bitraf/bitraf-hydroponics/board_1.1/bitraf_hydroponics-checks.md

Found probems: errors: 3, warnings: 16, notes: 1

General notes:
  highest-component: Highest component C2 is 1.45 mm

Ref: L1, MPN: NRS8040T150MJGJ
  mismatched-footprint: From schema: 'Inductors_SMD:L_Taiyo-Yuden_NR-80xx', from part database: 'Nonstandard'
Ref: P1, MPN: 1702473
  mismatched-footprint: No info about footprint from Digi-Key for 1702473
Ref: P10, MPN: 826926-4
  mismatched-footprint: No info about footprint from Digi-Key for 826926-4
Ref: P11, MPN: 1702473
  mismatched-footprint: No info about footprint from Digi-Key for 1702473
Ref: P12, MPN: 1702473
  mismatched-footprint: No info about footprint from Digi-Key for 1702473
Ref: P13, MPN: 826926-3
  mismatched-footprint: No info about footprint from Digi-Key for 826926-3
Ref: P14
  missing-part-number
Ref: P15, MPN: 826926-6
  mismatched-footprint: No info about footprint from Digi-Key for 826926-6
Ref: P16, MPN: PPPC031LFBN-RC
  mismatched-footprint: No info about footprint from Digi-Key for PPPC031LFBN-RC
Ref: P2, MPN: 1702473
  mismatched-footprint: No info about footprint from Digi-Key for 1702473
Ref: P3, MPN: 1702473
  mismatched-footprint: No info about footprint from Digi-Key for 1702473
Ref: P4, MPN: 1702473
  mismatched-footprint: No info about footprint from Digi-Key for 1702473
Ref: P5, MPN: 826926-5
  mismatched-footprint: No info about footprint from Digi-Key for 826926-5
Ref: P6, MPN: 826926-5
  mismatched-footprint: No info about footprint from Digi-Key for 826926-5
Ref: P7, MPN: 826926-4
  mismatched-footprint: No info about footprint from Digi-Key for 826926-4
Ref: P8, MPN: 826926-4
  mismatched-footprint: No info about footprint from Digi-Key for 826926-4
Ref: P9, MPN: 826926-4
  mismatched-footprint: No info about footprint from Digi-Key for 826926-4
Ref: R6
  missing-part-number
Ref: U3
  missing-part-number
