bitraf/bitraf-hydroponics/models/dome_45mm.fcstd

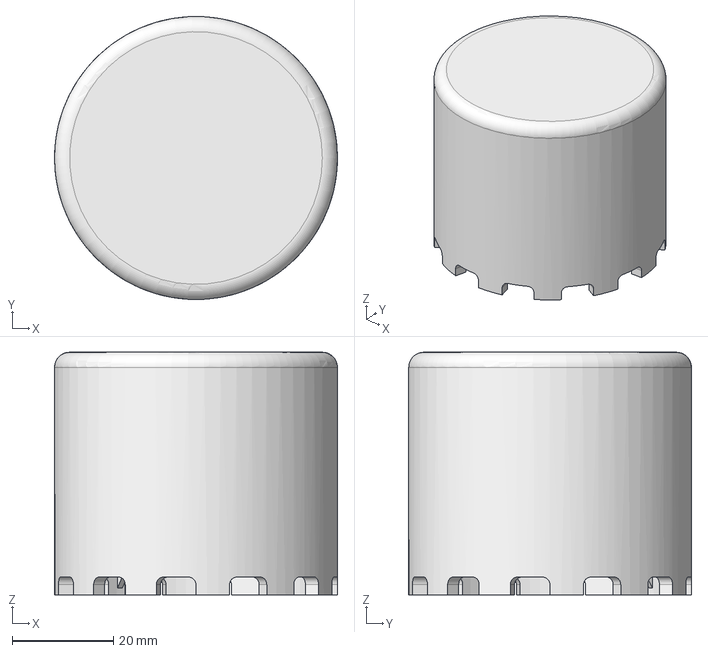
[picture p1: CAD file, 2017-10-05]
models/dome_45mm.fcstd
56.0 x 56.0 x 48.0 mm
