bitraf/bitraf-hydroponics/models/22mm_threaded_standpipe_30mm_quadribble.stl

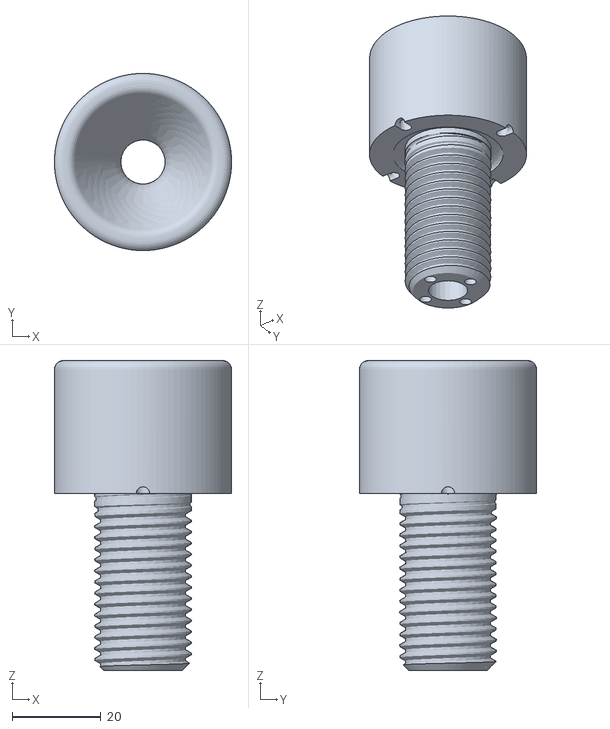
[picture p2: CAD file, 2017-10-05]
models/22mm_threaded_standpipe_30mm_quadribble.stl
40.0 x 40.0 x 70.0
