bitraf/bitraf-hydroponics/models/kuggis.fcstd

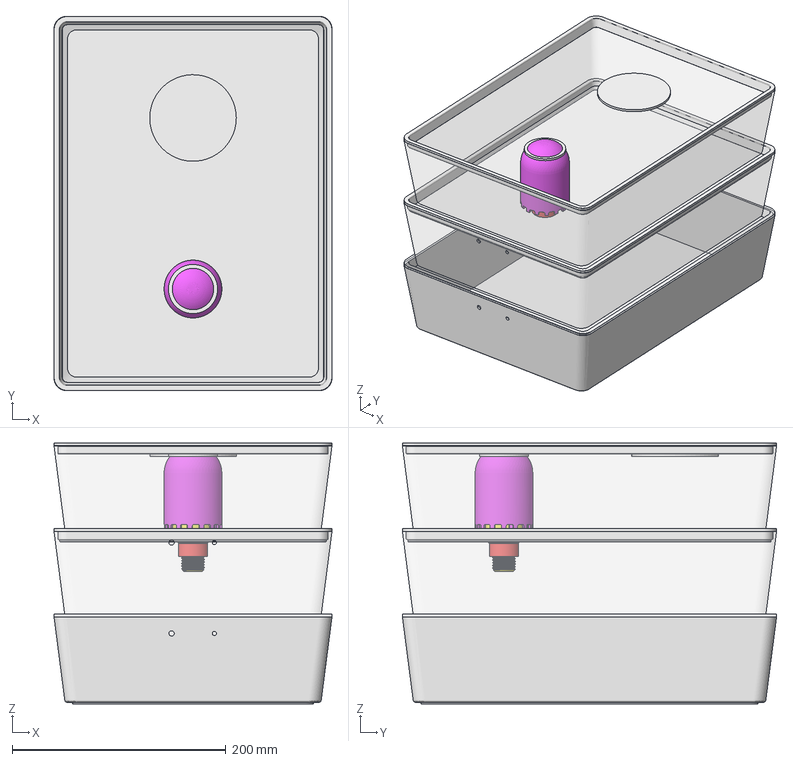
[picture p3: CAD file, 2017-05-18]
models/kuggis.fcstd
260.0 x 350.0 x 243.9 mm
Lid Bottom
Lid center
Box top
Box ceter
Box bottom
Dome_50_with_penises
threaded_standpipe_22mm_doubledribble
nut_22mm
