bitraf/bitraf-hydroponics/models/dome_50mm.fcstd

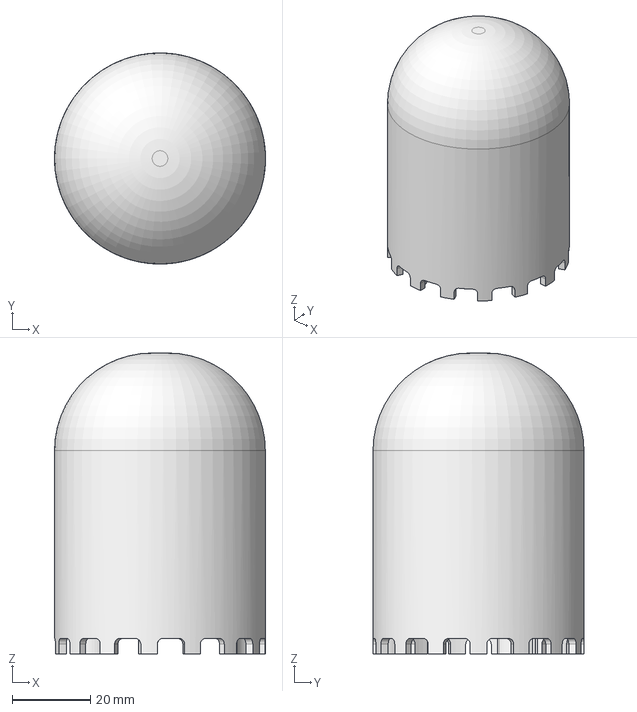
[picture p4: CAD file, 2017-05-18]
models/dome_50mm.fcstd
54.0 x 54.0 x 77.0 mm
