bitraf/bitraf-hydroponics/models/threaded_standpipe_22mm_quadribble.stl

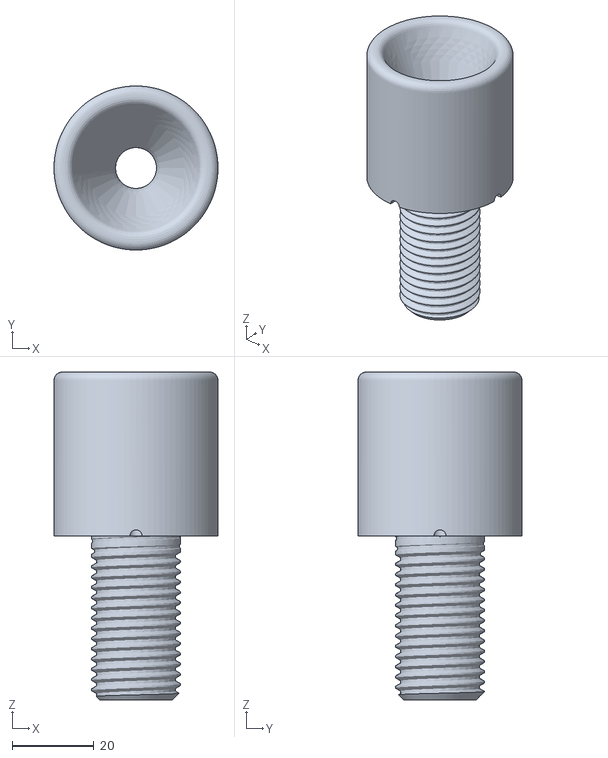
[picture p5: CAD file, 2016-10-16]
models/threaded_standpipe_22mm_quadribble.stl
40.0 x 40.0 x 80.0
