bitraf/bitraf-hydroponics/models/threaded_standpipe_22mm_doubledribble.stl

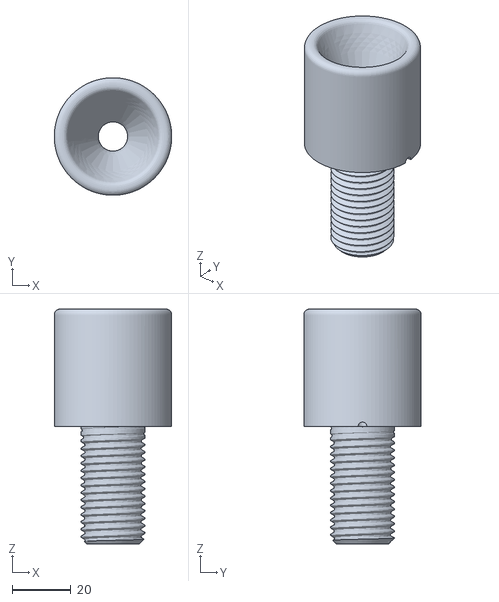
[picture p6: CAD file, 2016-10-13]
models/threaded_standpipe_22mm_doubledribble.stl
40.0 x 40.0 x 80.0
