bitraf/bitraf-hydroponics/models/bell_cradle.fcstd

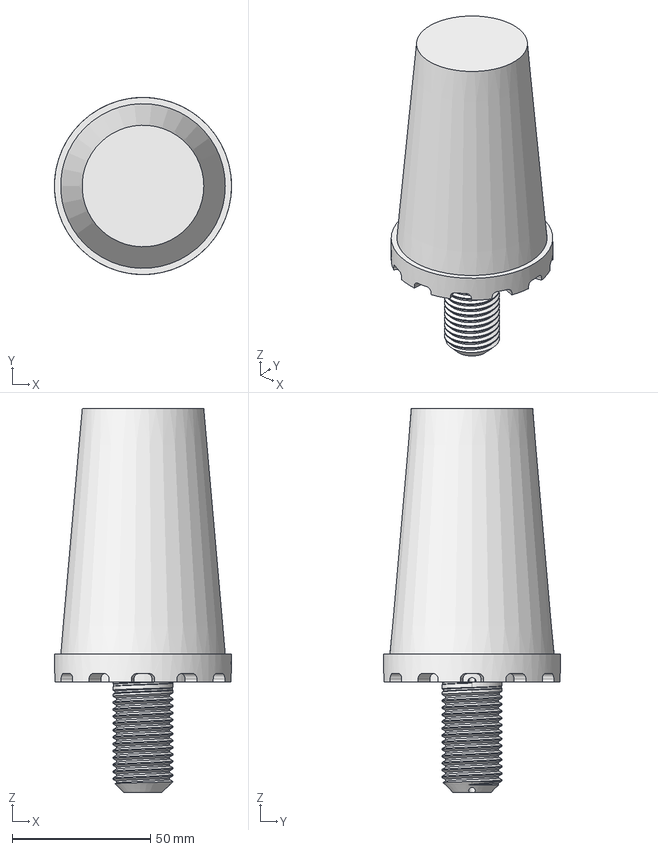
[picture p7: CAD file, 2016-10-13]
models/bell_cradle.fcstd
64.0 x 64.0 x 138.8 mm
