bitraf/bitraf-hydroponics/models/nut_22mm.fcstd

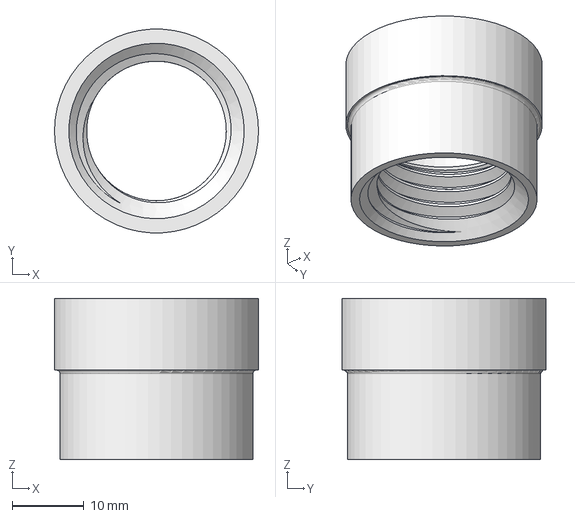
[picture p8: CAD file, 2016-10-04]
models/nut_22mm.fcstd
28.5 x 28.5 x 22.5 mm
