bitraf/bitraf-hydroponics/(list of files, cad)

Other CAD files:
models/dome_45mm.stl
models/nut_22mm.stl
