bitraf/bitraf-hydroponics/board_1.1/pdf/bitraf_hydroponics.pdf

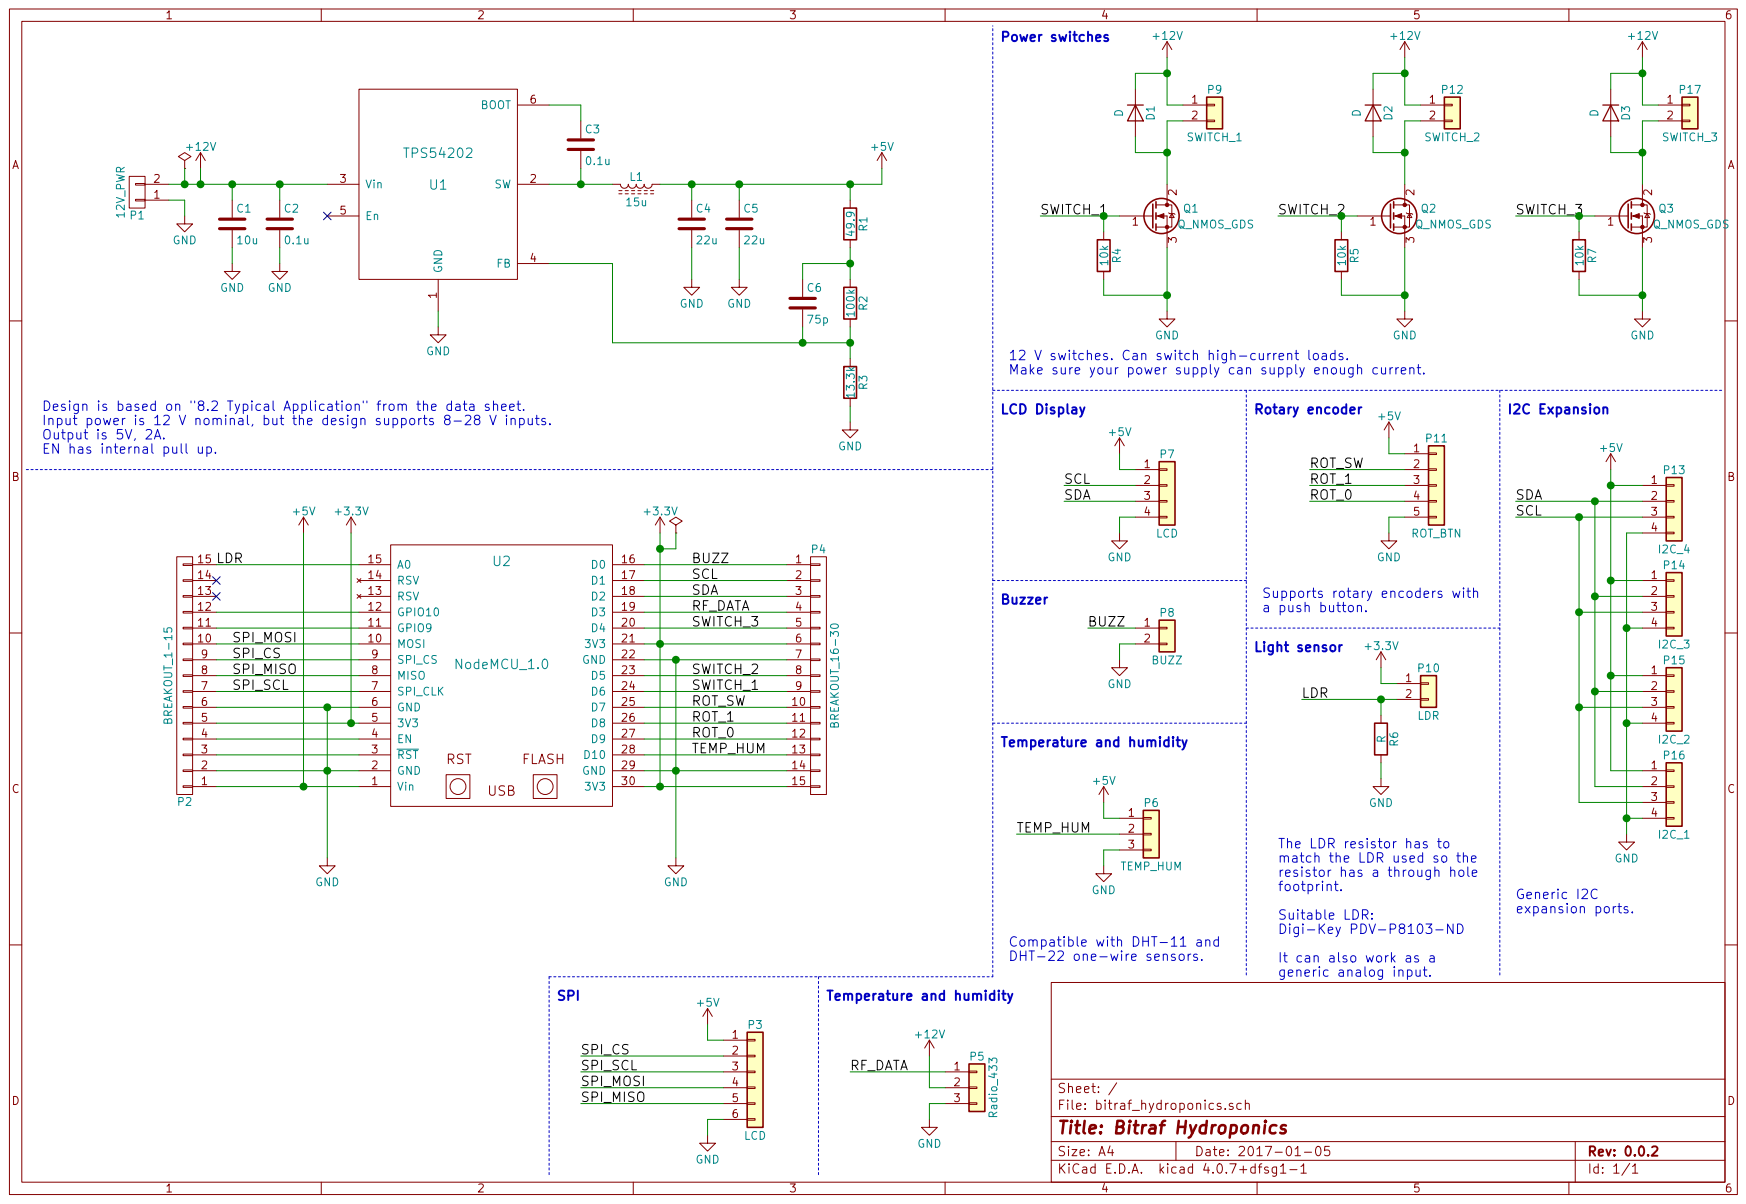
[picture p9: page 1]
