bitraf/bitraf-hydroponics/board_1.1/bitraf_hydroponics.kicad_pcb

## KiCad design board_1.1/bitraf_hydroponics.kicad_pcb (2017-11-09)

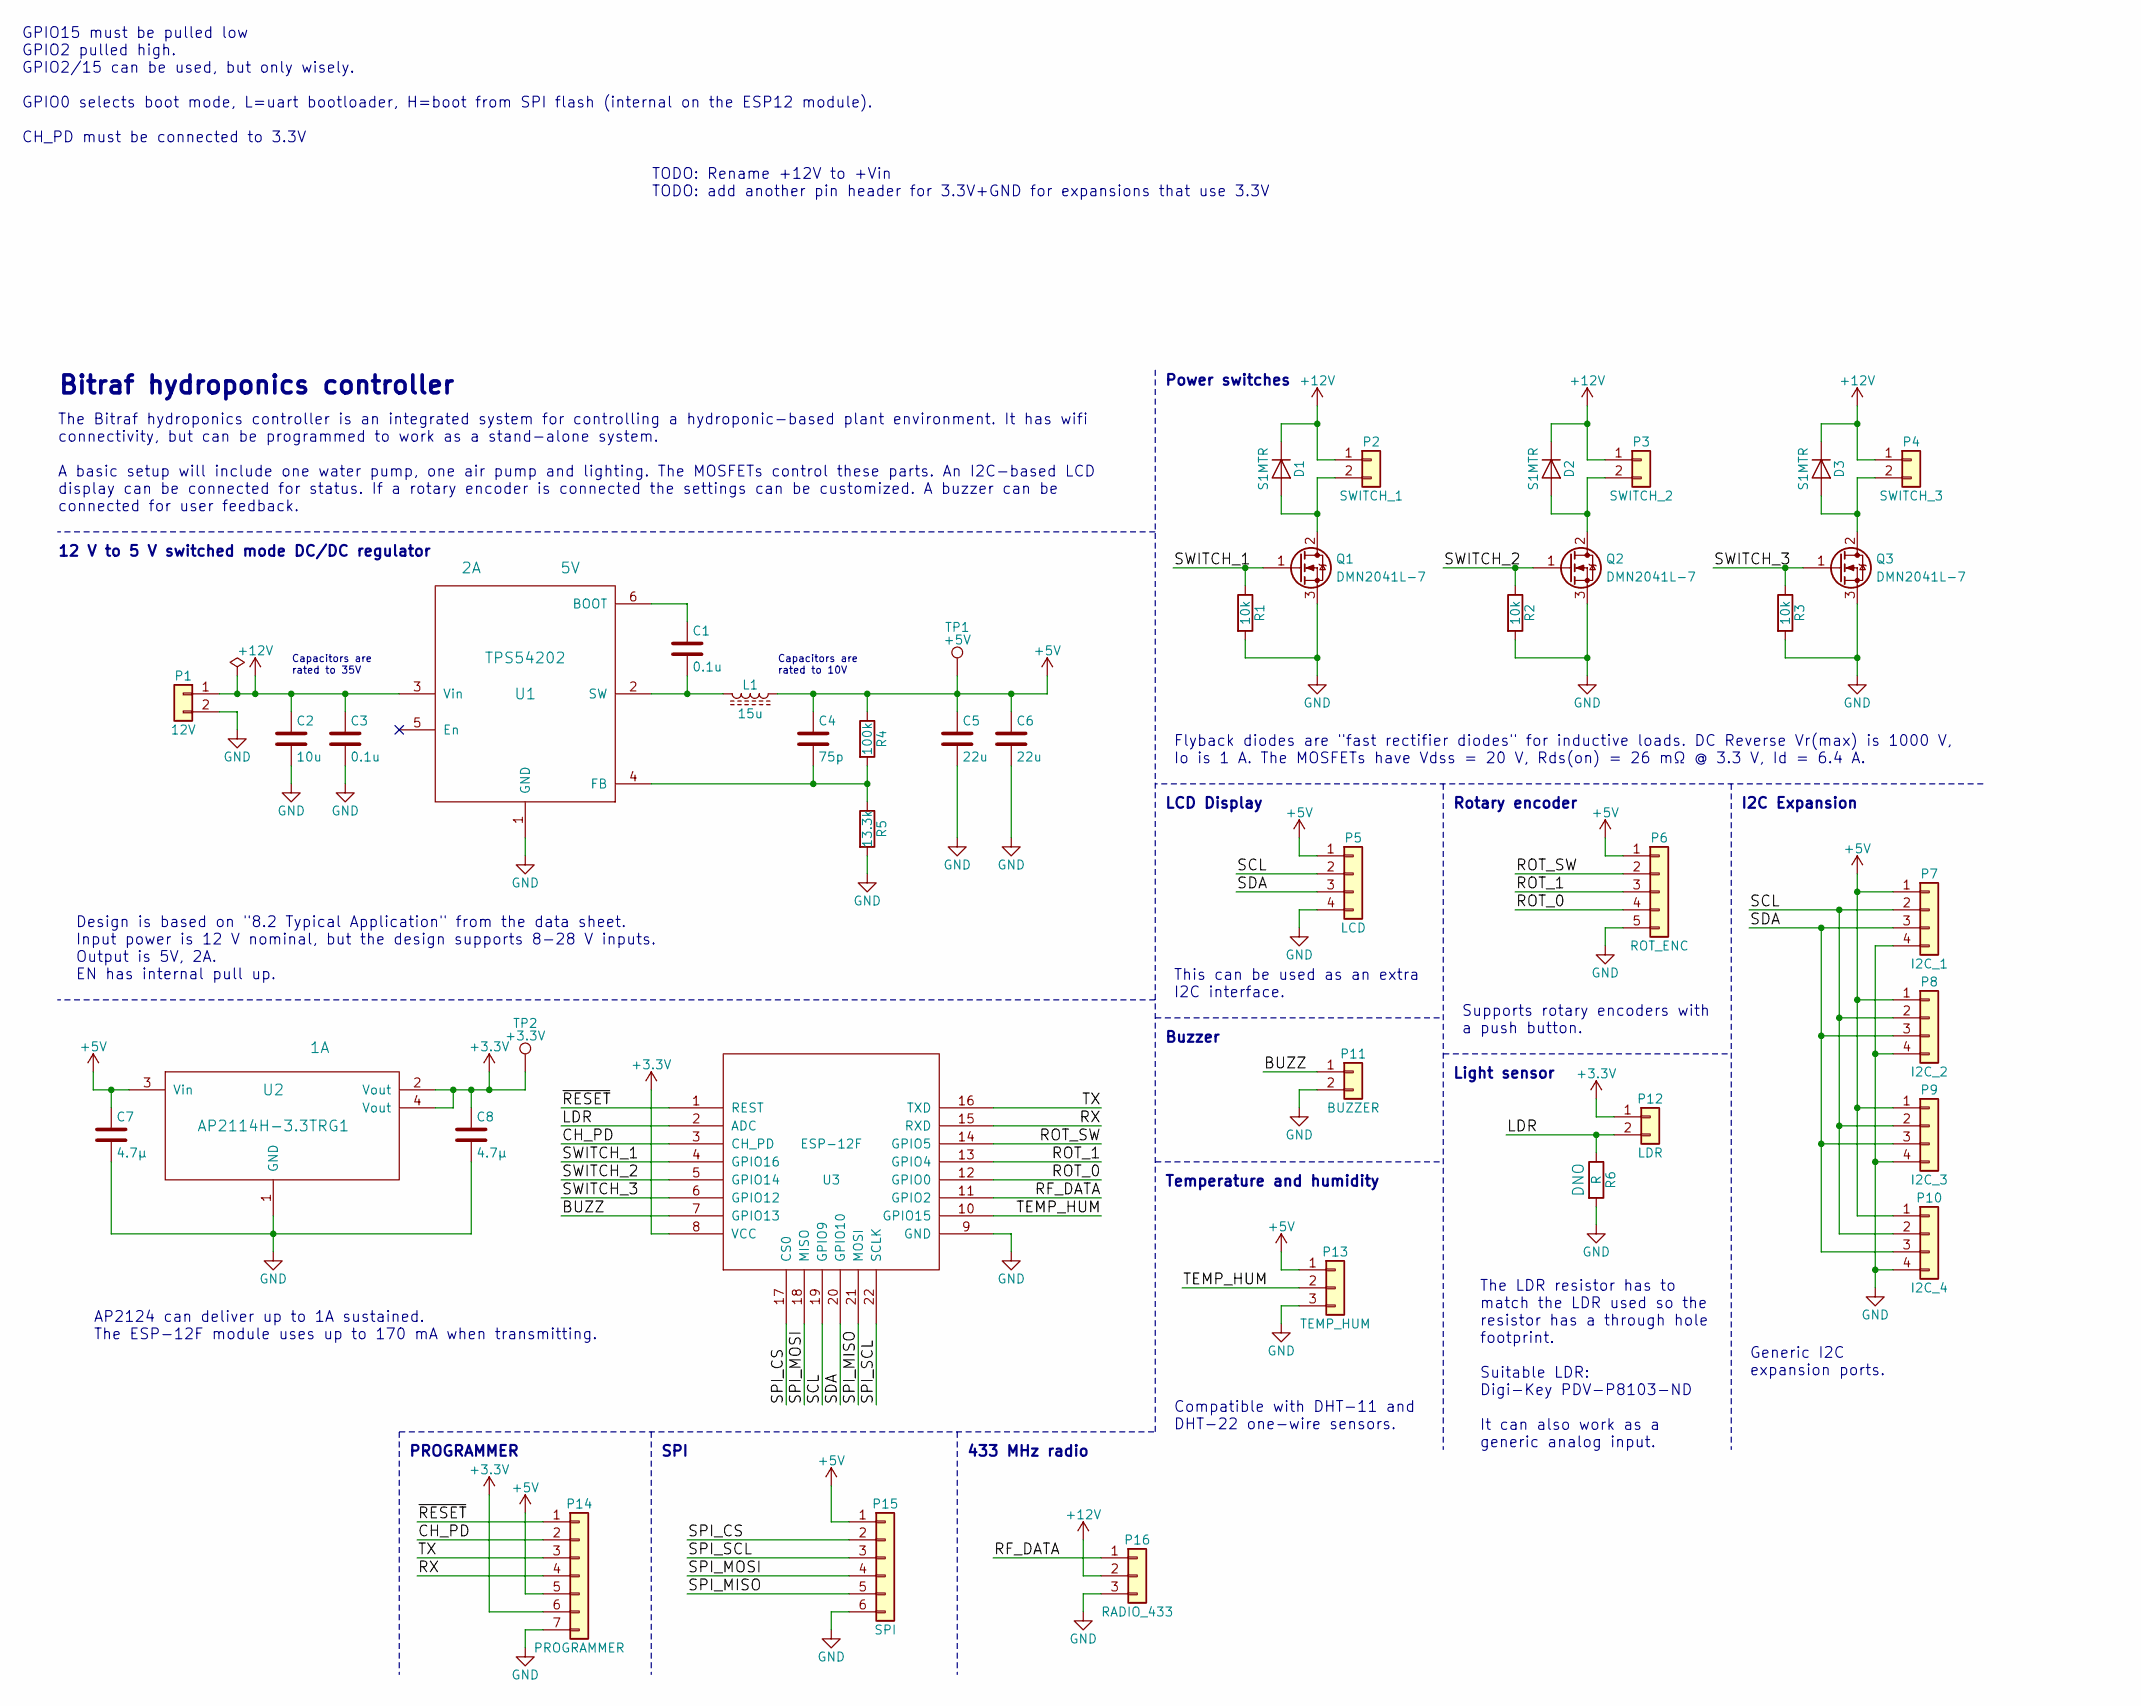
[picture p10: schematic bitraf_hydroponics.sch, Bitraf Hydroponics]

Parts:
C1: 0.1u; C_0805; voltage 10V; mpn CL21B104MBCNNNC
C2: 10u; C_0805; mpn GMK212BBJ106KG-T
C3: 0.1u; C_0805; mpn GMK212BJ104KGHT
C4: 75p; C_0805; voltage 10V; mpn 08051A750JAT2A
C5, C6: 22u; C_0805; voltage 10V; mpn CL21A226MQCLQNC
C7, C8: 4.7µ; C_0805; mpn LMK212BJ475KD-T
D1, D2, D3: S1MTR; D_SMA_Handsoldering; mpn S1MTR; digikey 1655-1506-2-ND
L1: 15u; L_Taiyo-Yuden_NR-80xx; mpn NRS8040T150MJGJ
P1: 12V; PhoenixContact_PTSM0,5_2-2,5-H_SMD; mpn 1702473
P2: SWITCH_1; PhoenixContact_PTSM0,5_2-2,5-H_SMD; mpn 1702473
P3: SWITCH_2; PhoenixContact_PTSM0,5_2-2,5-H_SMD; mpn 1702473
P4: SWITCH_3; PhoenixContact_PTSM0,5_2-2,5-H_SMD; mpn 1702473
P5: LCD; Pin_Header_Straight_1x04_Pitch2.54mm; mpn 826926-5
P6: ROT_ENC; Pin_Header_Straight_1x05_Pitch2.54mm; mpn 826926-5
P7: I2C_1; Pin_Header_Straight_1x04_Pitch2.54mm; mpn 826926-4
P8: I2C_2; Pin_Header_Straight_1x04_Pitch2.54mm; mpn 826926-4
P9: I2C_3; Pin_Header_Straight_1x04_Pitch2.54mm; mpn 826926-4
P10: I2C_4; Pin_Header_Straight_1x04_Pitch2.54mm; mpn 826926-4
P11: BUZZER; PhoenixContact_PTSM0,5_2-2,5-H_SMD; mpn 1702473
P12: LDR; PhoenixContact_PTSM0,5_2-2,5-H_SMD; mpn 1702473
P13: TEMP_HUM; Pin_Header_Straight_1x03_Pitch2.54mm; mpn 826926-3
P14: PROGRAMMER; Pin_Header_Straight_1x07_Pitch2.54mm
P15: SPI; Pin_Header_Straight_1x06_Pitch2.54mm; mpn 826926-6
P16: RADIO_433; Socket_Strip_Straight_1x03_Pitch2.54mm; mpn PPPC031LFBN-RC
Q1, Q2, Q3: DMN2041L-7; SOT-23; mpn DMN2041L-7
R1, R2, R3: 10k; R_0805; mpn RC0805FR-0710KL
R4: 100k; R_0805; mpn RC0805FR-07100KL
R5: 13.3k; R_0805; mpn RC0805FR-0713K3L
R6: R; R_Axial_DIN0207_L6.3mm_D2.5mm_P10.16mm_Horizontal
TP1: +5V; Test_Point_Pad_d1.0mm
TP2: +3.3V; Test_Point_Pad_d1.0mm
U1: TPS54202; SOT-23-6_Handsoldering; mpn TPS54202DDCT
U2: AP2114H-3.3TRG1; SOT-223; mpn AP2114H-3.3TRG1
U3: ESP-12F; ESP-12E

Connections:
+3V3: C8.1, P12.1, P14.6, TP2.1, U2.2 (Vout), U2.4 (Vout), U3.8 (VCC)
+5V: C4.1, C5.1, C6.1, C7.1, L1.1, P5.1, P6.1, P7.1, P8.1, P9.1, P10.1, P13.1, P14.5, P15.1, R4.1, TP1.1, U2.3 (Vin)
+12V: C2.1, C3.1, D1.1 (K), D2.1 (K), D3.1 (K), P1.1, P2.1, P3.1, P4.1, P16.2, U1.3 (Vin)
/BUZZ: P11.1, U3.7 (GPIO13)
/CH_PD: P14.2, U3.3 (CH_PD)
/LDR: P12.2, R6.1, U3.2 (ADC)
/RF_DATA: P16.1, U3.11 (GPIO2)
/ROT_0: P6.4, U3.12 (GPIO0)
/ROT_1: P6.3, U3.13 (GPIO4)
/ROT_SW: P6.2, U3.14 (GPIO5)
/RX: P14.4, U3.15 (RXD)
/SCL: P5.2, P7.2, P8.2, P9.2, P10.2, U3.19 (GPIO9)
/SDA: P5.3, P7.3, P8.3, P9.3, P10.3, U3.20 (GPIO10)
/SPI_CS: P15.2, U3.17 (CS0)
/SPI_MISO: P15.5, U3.21 (MOSI)
/SPI_MOSI: P15.4, U3.18 (MISO)
/SPI_SCL: P15.3, U3.22 (SCLK)
/SWITCH_1: Q1.1 (G), R1.1, U3.4 (GPIO16)
/SWITCH_2: Q2.1 (G), R2.1, U3.5 (GPIO14)
/SWITCH_3: Q3.1 (G), R3.1, U3.6 (GPIO12)
/TEMP_HUM: P13.2, U3.10 (GPIO15)
/TX: P14.3, U3.16 (TXD)
/~RESET: P14.1, U3.1 (REST)
GND: C2.2, C3.2, C5.2, C6.2, C7.2, C8.2, P1.2, P5.4, P6.5, P7.4, P8.4, P9.4, P10.4, P11.2, P13.3, P14.7, P15.6, P16.3, Q1.3 (S), Q2.3 (S), Q3.3 (S), R1.2, R2.2, R3.2, R5.2, R6.2, U1.1 (GND), U2.1 (GND), U3.9 (GND)
unnamed: C1.1, U1.6 (BOOT)
unnamed: C1.2, L1.2, U1.2 (SW)
unnamed: C4.2, R4.2, R5.1, U1.4 (FB)
unnamed: D1.2 (A), P2.2, Q1.2 (D)
unnamed: D2.2 (A), P3.2, Q2.2 (D)
unnamed: D3.2 (A), P4.2, Q3.2 (D)

Notes on the sheet:
Generic I2C expansion ports.
The LDR resistor has to match the LDR used so the resistor has a through hole footprint. Suitable LDR: Digi-Key PDV-P8103-ND It can also work as a generic analog input.
Rotary encoder
I2C Expansion
Temperature and humidity
Compatible with DHT-11 and DHT-22 one-wire sensors.
Supports rotary encoders with a push button.
Buzzer
Light sensor
LCD Display
433 MHz radio
Flyback diodes are "fast rectifier diodes" for inductive loads. DC Reverse Vr(max) is 1000 V, Io is 1 A. The MOSFETs have Vdss = 20 V, Rds(on) = 26 mΩ @ 3.3 V, Id = 6.4 A.
Power switches
Design is based on "8.2 Typical Application" from the data sheet. Input power is 12 V nominal, but the design supports 8-28 V inputs. Output is 5V, 2A. EN has internal pull up.
SPI
PROGRAMMER
AP2124 can deliver up to 1A sustained. The ESP-12F module uses up to 170 mA when transmitting.
Bitraf hydroponics controller
The Bitraf hydroponics controller is an integrated system for controlling a hydroponic-based plant environment. It has wifi connectivity, but can be programmed to work as a stand-alone system. A basic setup will include one water pump, one air pump and lighting. The MOSFETs control these parts. An 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
This can be used as an extra I2C interface.
12 V to 5 V switched mode DC/DC regulator
Capacitors are rated to 35V
Capacitors are rated to 10V
TODO: Rename +12V to +Vin TODO: add another pin header for 3.3V+GND for expansions that use 3.3V
GPIO15 must be pulled low GPIO2 pulled high. GPIO2/15 can be used, but only wisely. GPIO0 selects boot mode, L=uart bootloader, H=boot from SPI flash (internal on the ESP12 module). CH_PD must be connected to 3.3V

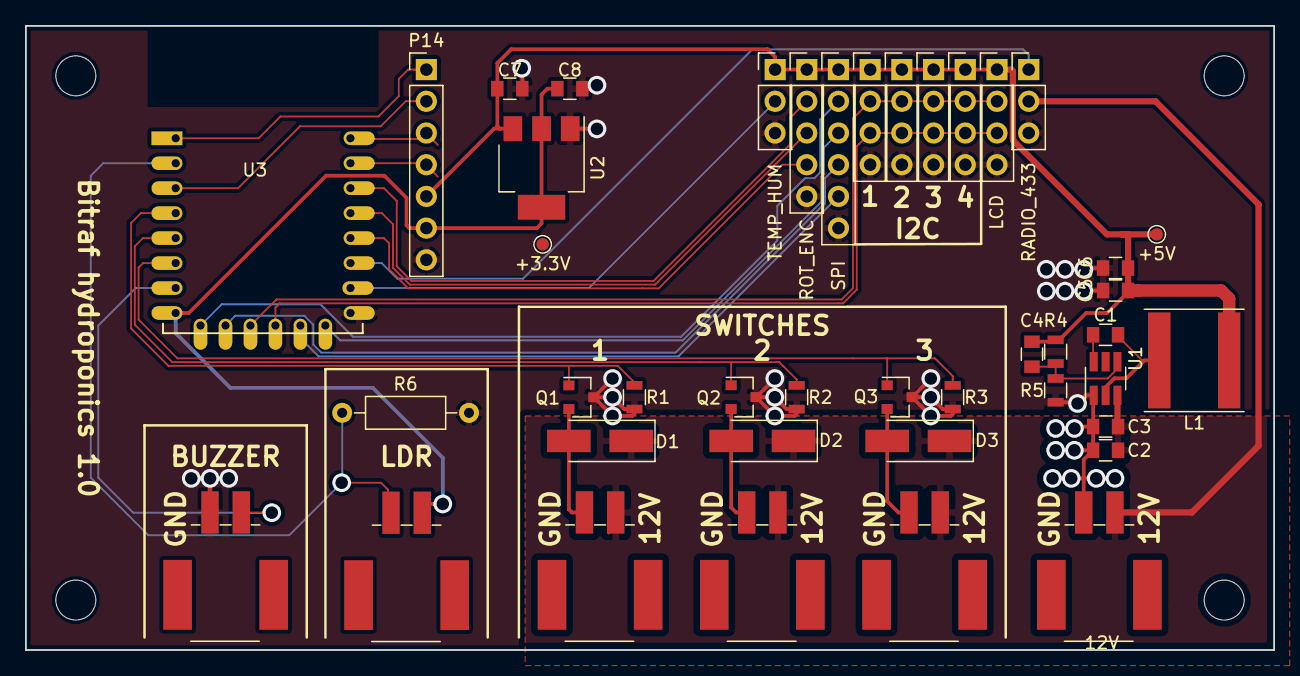
[picture p11: board board_1.1/bitraf_hydroponics.kicad_pcb from above]

Board: 2 copper layers, 100.0 x 50.0 mm, 42 parts (0 on the bottom side), 30 nets.
