bitraf/bitraf-hydroponics/board_0.0.2/bitraf_hydroponics.kicad_pcb

## KiCad design board_0.0.2/bitraf_hydroponics.kicad_pcb (2017-10-07)

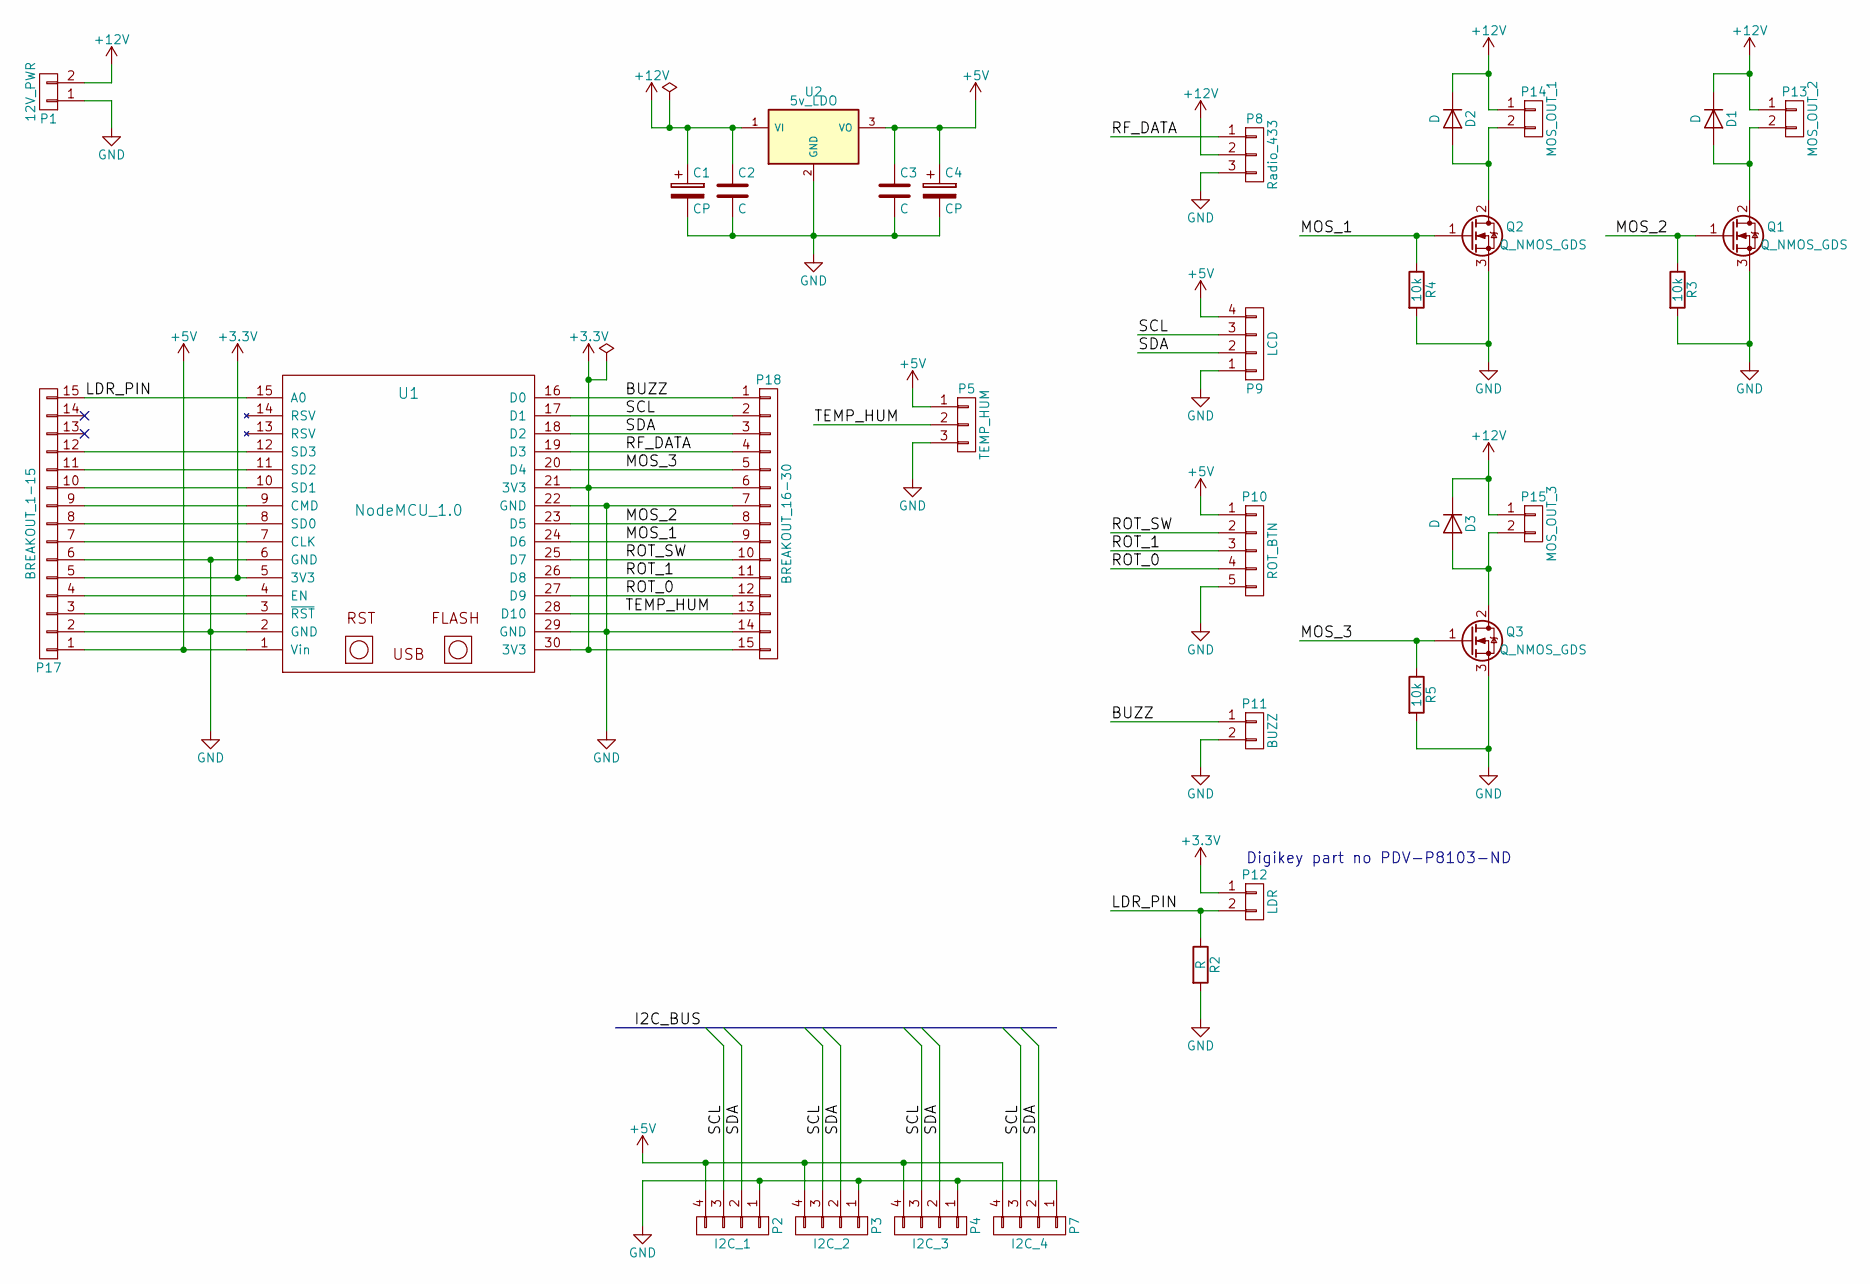
[picture p12: schematic bitraf_hydroponics.sch, Bitraf Hydroponics]

Parts:
C1, C4: CP; CP_Radial_D5.0mm_P2.50mm
C2, C3: C; C_Disc_D3.0mm_W2.0mm_P2.50mm
D1, D2, D3: D; D_DO-41_SOD81_P10.16mm_Horizontal
P1: 12V_PWR; TerminalBlock_Pheonix_MKDS1.5-2pol
P2: I2C_1; Pin_Header_Straight_1x04_Pitch2.54mm
P3: I2C_2; Pin_Header_Straight_1x04_Pitch2.54mm
P4: I2C_3; Pin_Header_Straight_1x04_Pitch2.54mm
P5: TEMP_HUM; Pin_Header_Straight_1x03_Pitch2.54mm
P7: I2C_4; Pin_Header_Straight_1x04_Pitch2.54mm
P8: Radio_433; Pin_Header_Straight_1x03_Pitch2.54mm
P9: LCD; Pin_Header_Straight_1x04_Pitch2.54mm
P10: ROT_BTN; Pin_Header_Straight_1x05_Pitch2.54mm
P11: BUZZ; Pin_Header_Straight_1x02_Pitch2.54mm
P12: LDR; Pin_Header_Straight_1x02_Pitch2.54mm
P13: MOS_OUT_2; TerminalBlock_Pheonix_MKDS1.5-2pol
P14: MOS_OUT_1; TerminalBlock_Pheonix_MKDS1.5-2pol
P15: MOS_OUT_3; TerminalBlock_Pheonix_MKDS1.5-2pol
P17: BREAKOUT_1-15; Pin_Header_Straight_1x15_Pitch2.54mm
P18: BREAKOUT_16-30; Pin_Header_Straight_1x15_Pitch2.54mm
Q1, Q2, Q3: Q_NMOS_GDS; TO-220_Vertical
R2: R; R_Axial_DIN0207_L6.3mm_D2.5mm_P10.16mm_Horizontal
R3, R4, R5: 10k; R_Axial_DIN0207_L6.3mm_D2.5mm_P10.16mm_Horizontal
U1: NodeMCU_1.0; NodeMCU
U2: 5v_LDO; TO-220_Vertical

Connections:
+3V3: P12.1, P17.5, P18.6, P18.15, U1.5 (3V3), U1.21 (3V3), U1.30 (3V3)
+5V: C3.1, C4.1, P2.4, P3.4, P4.4, P5.1, P7.4, P9.4, P10.1, P17.1, U1.1 (Vin), U2.3 (VO)
+12V: C1.1, C2.1, D1.1 (K), D2.1 (K), D3.1 (K), P1.2, P8.2, P13.1, P14.1, P15.1, U2.1 (VI)
/BUZZ: P11.1, P18.1, U1.16 (D0)
/LDR_PIN: P12.2, P17.15, R2.1, U1.15 (A0)
/MOS_1: P18.9, Q2.1 (G), R4.1, U1.24 (D6)
/MOS_2: P18.8, Q1.1 (G), R3.1, U1.23 (D5)
/MOS_3: P18.5, Q3.1 (G), R5.1, U1.20 (D4)
/RF_DATA: P8.1, P18.4, U1.19 (D3)
/ROT_0: P10.4, P18.12, U1.27 (D9)
/ROT_1: P10.3, P18.11, U1.26 (D8)
/ROT_SW: P10.2, P18.10, U1.25 (D7)
/SCL: P2.3, P3.3, P4.3, P7.3, P9.3, P18.2, U1.17 (D1)
/SDA: P2.2, P3.2, P4.2, P7.2, P9.2, P18.3, U1.18 (D2)
/TEMP_HUM: P5.2, P18.13, U1.28 (D10)
GND: C1.2, C2.2, C3.2, C4.2, P1.1, P2.1, P3.1, P4.1, P5.3, P7.1, P8.3, P9.1, P10.5, P11.2, P17.2, P17.6, P18.7, P18.14, Q1.3 (S), Q2.3 (S), Q3.3 (S), R2.2, R3.2, R4.2, R5.2, U1.2 (GND), U1.6 (GND), U1.22 (GND), U1.29 (GND), U2.2 (GND)
unnamed: D1.2 (A), P13.2, Q1.2 (D)
unnamed: D2.2 (A), P14.2, Q2.2 (D)
unnamed: D3.2 (A), P15.2, Q3.2 (D)
unnamed: P17.3, U1.3 (~RST)
unnamed: P17.4, U1.4 (EN)
unnamed: P17.7, U1.7 (CLK)
unnamed: P17.8, U1.8 (SD0)
unnamed: P17.9, U1.9 (CMD)
unnamed: P17.10, U1.10 (SD1)
unnamed: P17.11, U1.11 (SD2)
unnamed: P17.12, U1.12 (SD3)

Notes on the sheet:
Digikey part no PDV-P8103-ND

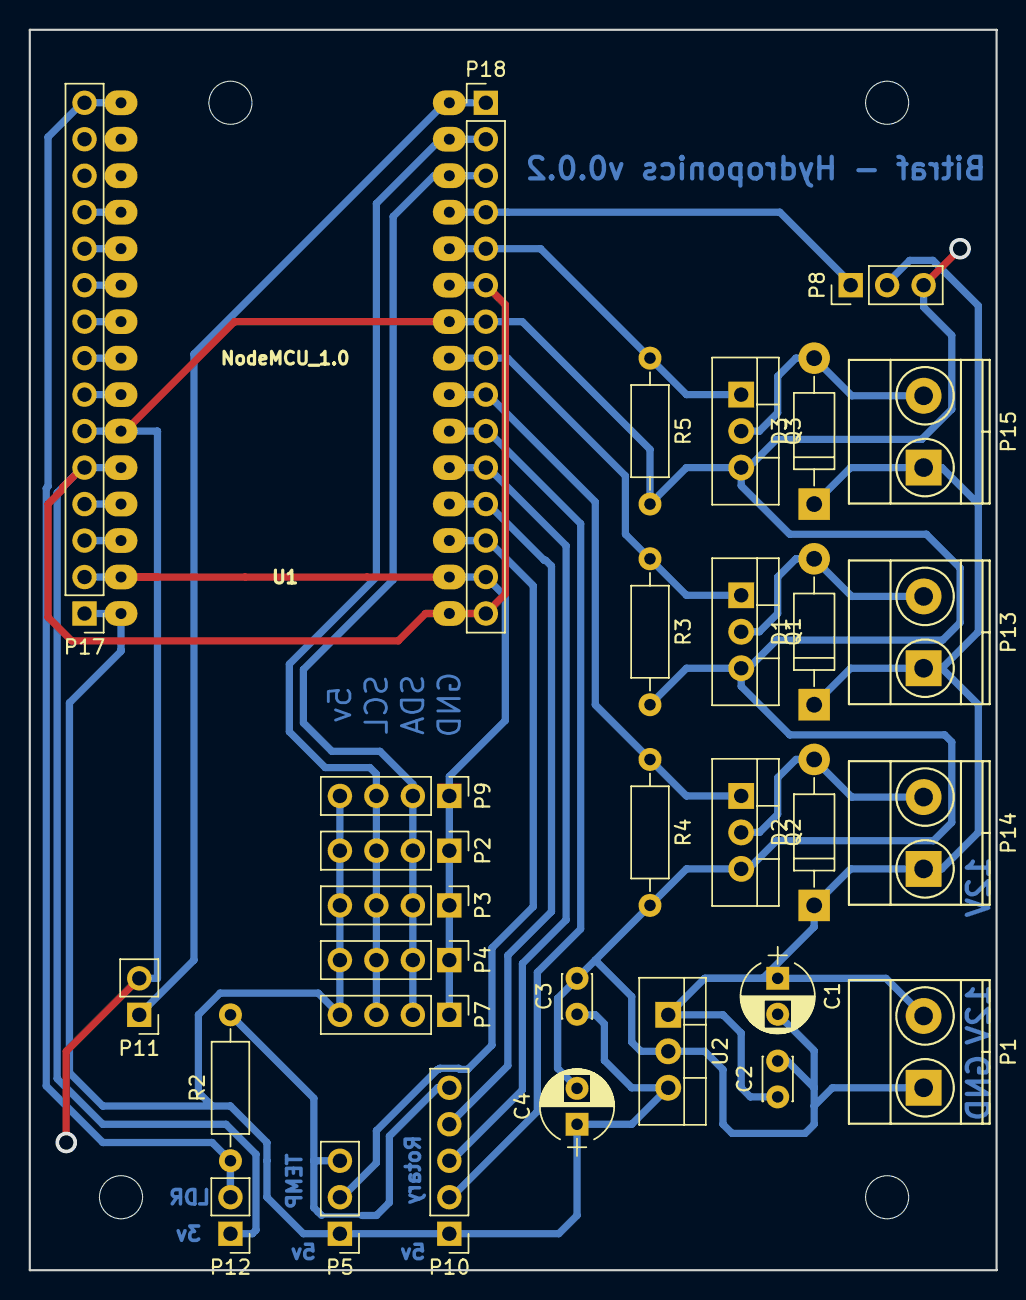
[picture p13: board board_0.0.2/bitraf_hydroponics.kicad_pcb from above]

Board: 2 copper layers, 67.3 x 86.4 mm, 32 parts (0 on the bottom side), 27 nets.
