bitraf/bitraf-hydroponics/software/Hydroponics/Hydroponics.ino

#include <Wire.h>  // This library is already built in to the Arduino IDE
#include <ArduinoOTA.h>
#include <WiFiClient.h>
#include <FS.h>
#include <stdio.h>

// Libraries that you have to install via Include Library > Manage Library
#include <PubSubClient.h>
#include "LiquidCrystal_I2C.h"
#include <TimeLib.h>      // "Time" library
#include <TimeAlarms.h>
#include <NtpClientLib.h>
#include <ArduinoJson.h>

// Custom headers
#include "wifipassword.h" //This is not commited to git so provide your own like example below.
#include "board_config.h"
#include "RotaryEncoder.h"
#include "tx433_Nexa.h"
#include "Ota.h"

// begin wifipassword.h example
//
// #define WIFI_SSID "myrouter"
// #define WIFI_PWD "myrouterspassword"
//
// End wifipassword.h example

// Nexa ID
String tx_nexa = "1010101010101010101010101010101010101010101010101010";
String ch_nexa="1010";

// Make sure we have a default value. This should be set in wifipassword.h
#ifndef FORMAT_SPIFFS
#define FORMAT_SPIFFS false
#endif

// Settings variables
unsigned long water_fill_time;
int light_time_on[2];
int light_time_on_prev[2];
int light_time_off[2];
int light_time_off_prev[2];
int air_time_on[2];
int air_time_on_prev[2];
int air_time_off[2];
int air_time_off_prev[2];
int water_cycles[4][2];
const char *wifi_ssid = WIFI_SSID;  //from wifipassword.h
const char *wifi_password = WIFI_PWD; //from wifipassword.h

static const bool ON = true;
static const bool OFF = false;

// RF transmit
Tx433_Nexa Nexa(RF_DATA, tx_nexa, ch_nexa);

// Water PIN
const int WATER_PUMP_PIN = SWITCH_1;

// Air pump PIN
const int AIR_PUMP_PIN = SWITCH_2;

// Track last water fill
unsigned long last_fill_start;

// Track if water is or should be on
bool water_on = false;

// Track if light is on or should be
bool light_on = false;
bool light_override = false;

// Track if air pump is on or should be
bool air_on = false;
bool air_override = false;

// Check water interval in minutes
const uint CHECK_WATER_INTERVAL = 1;

// WiFi Variables
WiFiClient wifi_client;

// LCD setup
LiquidCrystal_I2C lcd(0x3F, 16, 2);

// Rotary encoder setup
using decoder_t = RotaryEncoderDecoder<ROT_0, ROT_1, ROT_SW, uint16_t>;

void rotaryChange(duration_type duration_type, uint16_t click_length);
void rotaryMove(bool dir);

static decoder_t rotary(rotaryMove, rotaryChange);

void intrEncChange1() {
  rotary.intr1();
}

void intrEncChange2() {
  rotary.intr2();
}

// MQTT client
const char *mqtt_address = MQTT_ADDRESS;
const int mqtt_port = MQTT_PORT;
const char *mqtt_client_id = MQTT_CLIENT_ID;

PubSubClient mqtt_client(wifi_client);

// MQTT topics
const char *mqtt_topics[] = {
  "public/" DEVICE_ID "/lights-on",
  "public/" DEVICE_ID "/lights-off",
  "public/" DEVICE_ID "/light/command",
  "public/" DEVICE_ID "/air-on",
  "public/" DEVICE_ID "/air-off",
  "public/" DEVICE_ID "/water/watercycle/+",
  "public/" DEVICE_ID "/water/filltime",
  "public/" DEVICE_ID "/status/+",  //lights-on, lights-off, air-on, air-off, filltime, water[0-3]
  "public/" DEVICE_ID "/factory-reset",
  NULL
};

// MQTT Setup
void startMQTT(){
  mqtt_client.setServer(mqtt_address, mqtt_port);
  mqtt_client.setCallback(onMqttMsg);
  mqtt_client.connect(mqtt_client_id);
  Serial.print("MQTT Connecton state: ");
  Serial.println(mqtt_client.state());

  // loop through topics and subscribe
  int i = 0;
  while (mqtt_topics[i] != NULL){
    mqtt_client.subscribe(mqtt_topics[i], 1);
    mqtt_client.loop();
    i++;
  }
}

// Start NTP only after IP network is connected
void onSTAGotIP(WiFiEventStationModeGotIP ipInfo) {
	Serial.printf("Got IP: %s\r\n", ipInfo.ip.toString().c_str());
  Serial.println("Starting NTP");
	NTP.begin("pool.ntp.org", 1, true);
	NTP.setInterval(5, 63);
}

// Manage network disconnection
void onSTADisconnected(WiFiEventStationModeDisconnected event_info) {
	Serial.printf("Disconnected from SSID: %s\n", event_info.ssid.c_str());
	Serial.printf("Reason: %d\n", event_info.reason);
}

bool processSyncEvent(NTPSyncEvent_t ntpEvent) {
  if (ntpEvent == timeSyncd){
    return true;
  } else {
    if (ntpEvent == noResponse)
			Serial.println("NTP server not reachable");
		else if (ntpEvent == invalidAddress)
			Serial.println("Invalid NTP server address");
    return false;
  }
}

boolean time_synced = false; // True if a time even has been triggered
NTPSyncEvent_t ntpEvent; // Last triggered event


void setDefaultValues(JsonObject& root){
  JsonObject& light = root.createNestedObject("lights");
  JsonArray& light_on = light.createNestedArray("on");
  light_on.add(8);
  light_on.add(0);
  JsonArray& light_off = light.createNestedArray("off");
  light_off.add(0);
  light_off.add(0);

  JsonObject& air = root.createNestedObject("air");
  JsonArray& air_on = air.createNestedArray("on");
  air_on.add(2);
  air_on.add(0);
  JsonArray& air_off = air.createNestedArray("off");
  air_off.add(10);
  air_off.add(0);

  JsonObject& watercycles = root.createNestedObject("watercycles");
  JsonArray& cycle_0 = watercycles.createNestedArray("0");
  cycle_0.add(0);
  cycle_0.add(0);
  JsonArray& cycle_1 = watercycles.createNestedArray("1");
  cycle_1.add(6);
  cycle_1.add(0);
  JsonArray& cycle_2 = watercycles.createNestedArray("2");
  cycle_2.add(12);
  cycle_2.add(0);
  JsonArray& cycle_3 = watercycles.createNestedArray("3");
  cycle_3.add(18);
  cycle_3.add(0);

  root["filltime"] = 180 * 1000;
}


void updateSettings(JsonObject& root){
  JsonObject& light = root.createNestedObject("lights");
  JsonArray& light_on = light.createNestedArray("on");
  light_on.add(light_time_on[0]);
  light_on.add(light_time_on[1]);
  JsonArray& light_off = light.createNestedArray("off");
  light_off.add(light_time_off[0]);
  light_off.add(light_time_off[1]);

  JsonObject& air = root.createNestedObject("air");
  JsonArray& air_on = air.createNestedArray("on");
  air_on.add(air_time_on[0]);
  air_on.add(air_time_on[1]);
  JsonArray& air_off = air.createNestedArray("off");
  air_off.add(air_time_off[0]);
  air_off.add(air_time_off[1]);

  JsonObject& watercycles = root.createNestedObject("watercycles");
  JsonArray& cycle_0 = watercycles.createNestedArray("0");
  cycle_0.add(water_cycles[0][0]);
  cycle_0.add(water_cycles[0][1]);
  JsonArray& cycle_1 = watercycles.createNestedArray("1");
  cycle_1.add(water_cycles[1][0]);
  cycle_1.add(water_cycles[1][1]);
  JsonArray& cycle_2 = watercycles.createNestedArray("2");
  cycle_2.add(water_cycles[2][0]);
  cycle_2.add(water_cycles[2][1]);
  JsonArray& cycle_3 = watercycles.createNestedArray("3");
  cycle_3.add(water_cycles[3][0]);
  cycle_3.add(water_cycles[3][1]);

  root["filltime"] = water_fill_time;
}

void applyInitialSettings(JsonObject& root){
  // Water fill time
  water_fill_time = root["filltime"];  // seconds * millis

  // Light timers
  light_time_on[0] = root["lights"]["on"][0];
  light_time_on[1] = root["lights"]["on"][1];

  light_time_off[0] = root["lights"]["off"][0];
  light_time_off[1] = root["lights"]["off"][1];

  // air timers
  air_time_on[0] = root["air"]["on"][0];
  air_time_on[1] = root["air"]["on"][1];

  air_time_off[0] = root["air"]["off"][0];
  air_time_off[1] = root["air"]["off"][1];

  // Water cycles
  water_cycles[0][0] = root["watercycles"]["0"][0];
  water_cycles[0][1] = root["watercycles"]["0"][1];
  water_cycles[1][0] = root["watercycles"]["1"][0];
  water_cycles[1][1] = root["watercycles"]["1"][1];
  water_cycles[2][0] = root["watercycles"]["2"][0];
  water_cycles[2][1] = root["watercycles"]["2"][1];
  water_cycles[3][0] = root["watercycles"]["3"][0];
  water_cycles[3][1] = root["watercycles"]["3"][1];

}

bool settingFileExists(){
  File f = SPIFFS.open("/hydrosettings.json", "r");

  bool found;

  if (!f)
    found = false;
  else
    found = true;

  f.close();
  return found;

}

String readSettings(){
  // Read settings file
  File f = SPIFFS.open("/hydrosettings.json", "r");
  String json = f.readStringUntil('\n');
  f.close();

  return json.c_str();
}

void writeSettings(JsonObject& root){
  // Save settings
  File f = SPIFFS.open("/hydrosettings.json", "w");
  root.printTo(f);
  f.close();
  Serial.println("Wrote settings to disk:");
  root.printTo(Serial);
}


void setup()
{
  // Init pins
  pinMode(WATER_PUMP_PIN, OUTPUT);
  digitalWrite(WATER_PUMP_PIN, LOW);
  pinMode(AIR_PUMP_PIN, OUTPUT);
  digitalWrite(AIR_PUMP_PIN, LOW);
  pinMode(SWITCH_3, OUTPUT);
  digitalWrite(SWITCH_3, LOW);

  Serial.begin(115200);
  Serial.println();
  Serial.println("Bitraf hydroponics");

  lcd.init();   // initializing the LCD
  lcd.backlight(); // Enable or Turn On the backlight
  lcd.setCursor(0, 0);
  //lcd.print("A"); // Start Print text to Line 1
  lcd.print("_-~/\., (\")"); // Start Print text to Line 1
  lcd.setCursor(0, 1);
  lcd.print("Line 2----------"); // Start Print Test to Line 2

  rotary.setup();
  attachInterrupt(digitalPinToInterrupt(ROT_0), intrEncChange1, CHANGE);
  attachInterrupt(digitalPinToInterrupt(ROT_1), intrEncChange2, CHANGE);

  setupOta();

  // load settings
  SPIFFS.begin();

  // Format filesystem if set to do so
  #if FORMAT_SPIFFS
    Serial.println("Formatting SPIFFS!");
    SPIFFS.format();
  #endif

  // Read or create system settings
  StaticJsonBuffer<672> json_buffer;
  if (settingFileExists()){
    String json;
    json = readSettings();
    JsonObject& root = json_buffer.parseObject(json.c_str());

    if (!root.success()){
      Serial.println("Parsing json failed!");

    } else {
      Serial.println("Parsing json succeeded!");
      root.printTo(Serial);
    }
    applyInitialSettings(root);
  // Create default settings
  } else {
    Serial.println("No settings file found. Creating initial defaults");
    JsonObject& root = json_buffer.createObject();
    setDefaultValues(root);
    writeSettings(root);
  }

  // initialize last_fill_start
  last_fill_start = millis();

  NTP.onNTPSyncEvent([](NTPSyncEvent_t event) {
		ntpEvent = event;
		time_synced = processSyncEvent(ntpEvent);
    if (time_synced){
      if (!mqtt_client.connected())
        startMQTT();
        phoneHome();
    }
	});

  static WiFiEventHandler e1, e2;
  WiFi.begin(wifi_ssid, wifi_password);
  e1 = WiFi.onStationModeGotIP(onSTAGotIP);// As soon WiFi is connected, start NTP Client
	e2 = WiFi.onStationModeDisconnected(onSTADisconnected);

}

void initAlarms(){
  static bool alarms_set = false;
  if (timeStatus() == timeSet && !alarms_set){
    // Initial Alarm setup
    Alarm.alarmRepeat(water_cycles[0][0], water_cycles[0][1], 0, waterOn);
    Alarm.alarmRepeat(water_cycles[1][0], water_cycles[1][1], 0, waterOn);
    Alarm.alarmRepeat(water_cycles[2][0], water_cycles[2][1], 0, waterOn);
    Alarm.alarmRepeat(water_cycles[3][0], water_cycles[3][1], 0, waterOn);
    Alarm.timerRepeat(0, CHECK_WATER_INTERVAL, 0, checkWateringStatus);
    alarms_set = true;
  }
}

void loop() {
  initAlarms();
  ArduinoOTA.handle();
  //rotary.loop();
  mqtt_client.loop();
  checkAction(light_time_on, light_time_off, toggleLights);
  checkAction(air_time_on, air_time_off, toggleAir);
  //phoneHome();
  Alarm.delay(0);
}

void phoneHome(){
  static long last = 0;
  if ((millis() - last) > 5100) {

    last = millis();
    Serial.print(NTP.getTimeDateString()); Serial.print(". ");
    Serial.print("WiFi is ");
    Serial.print(WiFi.isConnected() ? "connected" : "not connected"); Serial.print(". ");
    Serial.print("Uptime: ");
    Serial.print(NTP.getUptimeString()); Serial.print(" since ");
    Serial.println(NTP.getTimeDateString(NTP.getFirstSync()).c_str());
    Serial.print("Time now: ");
    digitalClockDisplay();
  }
}


void publishStatus(String& key){
  String status;

  if (key == "lights-on")
    status = String(light_time_on[0], DEC) + String(":") + String(light_time_on[1], DEC);
  else if (key == "lights-off")
    status = String(light_time_off[0], DEC) + String(":") + String(light_time_off[1], DEC);
  else if (key == "air-on")
    status = String(air_time_on[0], DEC) + String(":") + String(air_time_on[1], DEC);
  else if (key == "air-off")
    status = String(air_time_off[0], DEC) + String(":") + String(air_time_off[1], DEC);
  else if (key == "filltime")
    status = String(water_fill_time / 1000, DEC);
  else if (key == "water0")
    status = String(water_cycles[0][0], DEC) + String(":") + String(water_cycles[0][1], DEC);
  else if (key == "water1")
    status = String(water_cycles[1][0], DEC) + String(":") + String(water_cycles[1][1], DEC);
  else if (key == "water2")
    status = String(water_cycles[2][0], DEC) + String(":") + String(water_cycles[2][1], DEC);
  else if (key == "water3")
    status = String(water_cycles[3][0], DEC) + String(":") + String(water_cycles[3][1], DEC);
  else
    status = "\"" + key + "\" is not supported yet";

  // Publish status
  Serial.println(status);
  bool res;
  res = mqtt_client.publish("public/" DEVICE_ID "/status-result", status.c_str());
  if (!res)
    Serial.println("Publish failed!");
}


void onMqttMsg(char* _topic, byte* payload, unsigned int length) {
  String topic(_topic);
  String value;
  bool modified = false;

  value.reserve(length + 1);
  for (unsigned int i = 0; i < length; i++) {
    value += static_cast<char>(payload[i]);
  }

  if (topic.indexOf("/status/") != -1){
    int index = topic.indexOf("/status/");
    String key = topic.substring(index + 8);
    publishStatus(key);

  } else if (topic.endsWith("/lights-on")) {
    if (value == "now"){
      Serial.println("Lights on now!");
      light_time_on[0] = hour();
      light_time_on[1] = minute();
      toggleLights(ON);
      light_override = true;
    } else if (parseTime(value, light_time_on)) {
      Serial.print("Setting new light on time: ");
      Serial.println(value);
      modified = true;
    }
  } else if (topic.endsWith("/lights-off")) {
    if (value == "now"){
      Serial.println("Lights off now!");
      light_time_off[0] = hour();
      light_time_off[1] = minute();
      toggleLights(OFF);
      light_override = true;
    } else if (parseTime(value, light_time_off)) {
      Serial.print("Setting new light off time: ");
      Serial.println(value);
      modified = true;
    }
  } else if (topic.endsWith("/air-on")) {
    if (value == "now"){
      Serial.println("Air on now!");
      air_time_on[0] = hour();
      air_time_on[1] = minute();
      toggleAir(ON);
      air_override = true;
    } else if (parseTime(value, air_time_on)) {
      Serial.print("Setting new air on time: ");
      Serial.println(value);
      modified = true;
    }
  } else if (topic.endsWith("/air-off")) {
    if (value == "now"){
      Serial.println("Air off now!");
      air_time_off[0] = hour();
      air_time_off[1] = minute();
      toggleAir(OFF);
      air_override = true;
    } else if (parseTime(value, air_time_off)) {
      Serial.print("Setting new air off time: ");
      Serial.println(value);
      modified = true;
    }
  } else if (topic.endsWith("/water/filltime")) {
    long filltime = value.toInt();
    if (filltime != 0 && filltime > 0) {
      Serial.print("Setting new water fill time: ");
      Serial.println(value);
      water_fill_time = value.toInt() * 1000;
      modified = true;
    }
  } else if (topic.indexOf("/watercycle/") != -1){
    int index = topic.indexOf("/watercycle/");
    int cycle_num = topic.substring(index + 12).toInt();

    if (cycle_num < -1 || cycle_num > 3)
      return;

    if (cycle_num == -1){
      Serial.println("Toggle Water!");
      if (water_on)
        waterOff();
      else
        waterOn();

      // Water NOW or for value amount of time
    } else if (parseTime(value, water_cycles[cycle_num])){
      Serial.print("Setting new time for water cycle number ");
      Serial.print(cycle_num);
      Serial.print(": ");
      Serial.println(value);
      Serial.print("Alarm time before: ");
      Serial.println(Alarm.read(cycle_num));
      Alarm.write(cycle_num, AlarmHMS(water_cycles[cycle_num][0], water_cycles[cycle_num][1], 0));
      Serial.print("Alarm time after: ");
      Serial.println(Alarm.read(cycle_num));
      modified = true;
    }
  }

  if (modified){
    StaticJsonBuffer<672> json_buffer;
    JsonObject& root = json_buffer.createObject();
    updateSettings(root);
    writeSettings(root);
  }
}

bool parseTime(const String &value, int (& t)[2]){
  uint colon = value.indexOf(":");

  if (colon == -1) {
    Serial.println("Failed parsing time. No colon found");
    return false;
  }

  String hour_sub = value.substring(0, colon);
  String minute_sub = value.substring(colon + 1);

  if (hour_sub.length() >= 1 && minute_sub.length() >= 1){
    int hour_int = hour_sub.toInt();
    int minute_int = minute_sub.toInt();

    if (hour_int < 0 || hour_int > 23){
      Serial.print("parseTime Failed! Hour out of range: ");
      Serial.println(hour_int);
      return false;
    }

    if (minute_int < 0 || minute_int > 59) {
      Serial.print("parseTime Failed! Minute out of range: ");
      Serial.println(minute_int);
      return false;
    }

    // Success!
    t[0] = hour_int;
    t[1] = minute_int;

    return true;
  }

  Serial.println("Failed parsing time. Digits missing before or after colon");
  return false;
}


int timeToMin(int (& t)[2]){
  int hours_as_minutes = t[0] * 60;

  return t[1] + hours_as_minutes;
}


// Check if we should run passed function
void checkAction(int (& in)[2], int (& out)[2], void (* func)(bool state)){
  if (!time_synced)
    return ;

  int on = timeToMin(in);
  int off = timeToMin(out);
  int n[2] = {hour(), minute()};
  int now = timeToMin(n);

  if (on < off)
    if (now >= on  && now < off)
      func(ON);
    else
      func(OFF);

  if (on > off)
    if (off == 0)
      if (now >= on)
        func(ON);
      else
        func(OFF);
    else
      if (now >= on || now < off)
        func(ON);
      else
        func(OFF);
}


// switch lights
void toggleLights(bool state){
  if (state){
    if (!light_on) {
      Nexa.Device_On(0);
      light_on = true;
      Serial.println("Light on, Good morning!");
      mqtt_client.publish("public/" DEVICE_ID "/status-result", "lights on");

      if (light_override){
        // Restore settings
        String json = readSettings();
        StaticJsonBuffer<672> json_buffer;
        JsonObject& root = json_buffer.parseObject(json.c_str());

        light_time_off[0] = root["lights"]["off"][0];
        light_time_off[1] = root["lights"]["off"][1];
        light_override = false;
      }
    }
  } else {
    if (light_on) {
      Nexa.Device_Off(0);
      light_on = false;
      Serial.println("Light Off, Good nights!");
      mqtt_client.publish("public/" DEVICE_ID "/status-result", "lights off");

      if (light_override){
        // Restore settings
        String json = readSettings();
        StaticJsonBuffer<672> json_buffer;
        JsonObject& root = json_buffer.parseObject(json.c_str());

        light_time_on[0] = root["lights"]["on"][0];
        light_time_on[1] = root["lights"]["on"][1];
        light_override = false;
      }
    }
  }
}

void toggleAir(bool state){
  if (state){
    if (!air_on) {
      digitalWrite(AIR_PUMP_PIN, HIGH);
      air_on = true;
      Serial.println("Air Pump On, I can breathe!");
      mqtt_client.publish("public/" DEVICE_ID "/status-result", "air on");

      if (air_override){
        // Restore settings
        String json = readSettings();
        StaticJsonBuffer<672> json_buffer;
        JsonObject& root = json_buffer.parseObject(json.c_str());

        air_time_off[0] = root["air"]["off"][0];
        air_time_off[1] = root["air"]["off"][1];
        air_override = false;
      }
    }
  } else {
    if (air_on) {
      digitalWrite(AIR_PUMP_PIN, LOW);
      air_on = false;
      Serial.println("Air Pump Off, Enough fresh air!");
      mqtt_client.publish("public/" DEVICE_ID "/status-result", "air off");

      if (air_override){
        // Restore settings
        String json = readSettings();
        StaticJsonBuffer<672> json_buffer;
        JsonObject& root = json_buffer.parseObject(json.c_str());

        air_time_on[0] = root["air"]["on"][0];
        air_time_on[1] = root["air"]["on"][1];
        air_override = false;
      }
    }
  }
}

void waterOn(){
  if (water_on){
    Serial.println("Water is already on");
  } else {
    Serial.println("Turn on water");
    digitalWrite(WATER_PUMP_PIN, HIGH);
    Alarm.timerOnce(water_fill_time / 1000, waterOff);
    last_fill_start = millis();
    water_on = true;
  }
}

void waterOff(){
  if (water_on) {
    Serial.println("Water OFF");
    digitalWrite(WATER_PUMP_PIN, LOW);
    water_on = false;
  }
}

void checkWateringStatus(){
  unsigned long diff = millis() - last_fill_start;
  bool pumping = (digitalRead(WATER_PUMP_PIN) == HIGH);

  if (pumping && diff > water_fill_time){
    Serial.println("Water on passed fill time ");
    waterOff();
  }
  else if (pumping && diff < water_fill_time) {
    Serial.println("Within fill cycle, all OK");
  }
  else if (!pumping && water_on && diff < water_fill_time) {
    Serial.println("Within fill cycle, resume OK");
    waterOn();
  }
  else {
    waterOff();
    Serial.println("Water off, all OK");
  }
}


void digitalClockDisplay(){
  // digital clock display of the time
  Serial.print(hour());
  printDigits(minute());
  printDigits(second());
  Serial.print(" ");
  Serial.print(day());
  Serial.print(".");
  Serial.print(month());
  Serial.print(".");
  Serial.print(year());
  Serial.println();
}

void printDigits(int digits){
  // utility for digital clock display: prints preceding colon and leading 0
  Serial.print(":");
  if(digits < 10)
    Serial.print('0');
  Serial.print(digits);
}

void rotaryMove(bool dir) {
  static int count = 0;
  Serial.println(dir ? ">>>" : "<<<");
  lcd.setCursor(0, 0);
  lcd.print(dir ? ">>>" : "<<<");
  lcd.setCursor(0, 1);
  count += dir ? 1 : -1;
  lcd.print(count);
}

void rotaryChange(duration_type duration_type, uint16_t duration) {

  static const char* pressText[] = {
    "really quick press!",
    "short press",
    "normal press",
    "long press",
    "very looooooooong press"
  };

  Serial.print("released selecting: ");
  Serial.print(rotary.currentValue(), DEC);
  Serial.print(" (after ");
  Serial.print(duration);
  Serial.print(" ms = ");
  Serial.print(pressText[static_cast<int>(duration_type)]);
  Serial.println(")");
}
