bitraf/bitraf-hydroponics/(commit log)

2016-09-22 first aproach on schema ready. Begun placing parts
    [bitraf_hydroponics.kicad_pcb, bitraf_hydroponics.sch]
2016-09-28 o A FreeCAD model of IKEA Kuggis.
    [kuggis.fcstd]
2016-09-29 Getting on with placing and tracing
    [bitraf_hydroponics.kicad_pcb, bitraf_hydroponics.sch]
2016-09-30 Parts placed and traced. Need to define board and ground plane
    [bitraf_hydroponics.kicad_pcb, bitraf_hydroponics.sch]
2016-10-02 added mounting holes, edge cut and copper fill
    [bitraf_hydroponics.kicad_pcb]
2016-10-04 for slicing
    [threaded_standpipe_22mm_doubledribble.stl]
2016-10-04 got nuts?
    [nut_22mm.fcstd, nut_22mm.stl]
2016-10-06 o Adding display and button mount. Should be moved out to a separate file.
    [kuggis.fcstd]
2016-10-06 Added the i2c display library
2016-10-06 o Rotary encoder, go!
2016-10-13 adjusted screw end. Expanded siphon and double siphon tubes
    [bell_cradle.fcstd, threaded_standpipe_22mm_doubledribble.stl]
2016-10-13 adjusted mini siphon to avoid gaps aka leaks
    [threaded_standpipe_22mm_doubledribble.stl]
2016-10-16 wider o-ring cavity and quadripple siphon action
    [threaded_standpipe_22mm_quadribble.stl]
2017-01-12 new revision
    [bitraf_hydroponics.kicad_pcb, bitraf_hydroponics.sch]
2017-01-12 fixed Vin bug. Traced new route for buzz and ldr. Added resistors to terminals
    [bitraf_hydroponics.kicad_pcb, bitraf_hydroponics.sch]
2017-03-09 nitial commit
    [dome_50mm.fcstd]
2017-03-09 Updated Kuggis, moar accurate model
    [kuggis.fcstd]
2017-03-09 Updated Kuggis, removed panel
    [kuggis.fcstd]
2017-04-27 changed name of device
2017-04-27 now with air pump alarm. Spaghetti wet wet wet code, but seems to work.
2017-05-07 removed counter in phoneHome to avoid possible mangled int. Also reverted to print the whole settings.json on status topic appending refactor of the whole status idea
    [Hydroponics.ino]
2017-05-18 Added option to override light
    [dome_50mm.fcstd, kuggis.fcstd]
2017-05-18 removed wifi from json settings. may have caused issues and won't be useful yet
    [Hydroponics.ino]
2017-06-01 Dynamic hostname based on DEVICE_ID
2017-06-19 moved i2c bus out of the way for USB and rerouted. Also removed resistors over terminals
    [bitraf_hydroponics.kicad_pcb, bitraf_hydroponics.sch]
2017-06-29 switched to static json buffer
2017-09-15 adjustet height of funnel
    [22mm_threaded_standpipe_30mm_quadribble.stl]
2017-10-05 pcb: not exactly sure what I did, but it passes the tests. Models: tweaked to work with the low kuggis bed. New dome fits perfectly over stand pipe
    [22mm_threaded_standpipe_30mm_quadribble.stl, bitraf_hydroponics.kicad_pcb, dome_45mm.fcstd, dome_45mm.stl]
2017-10-07 o Refreshing footprints with updated KiCAD libraries. All parts have 3D-models now except the NodeMCU. o Adding some more text on the copper. o Fixing a couple of ERC warnings.
    [bitraf_hydroponics.kicad_pcb, bitraf_hydroponics.sch]
2017-10-12 Initial import of rev 1.0. Main features: o Almost all SMD components. o Using a switching regulator instead of LDO for 12 -> 5V convertion. o Adding SPI output.
    [bitraf_hydroponics.kicad_pcb, bitraf_hydroponics.sch]
2017-10-19 o Removing old PCB layout.
    [bitraf_hydroponics.kicad_pcb]
2017-10-19 o Replacing NodeMCU with a single ESP-12F module and an LDO. Will need an external programmer.
    [bitraf_hydroponics.sch]
2017-10-20 o Selecting components for flyback diodes. o Adding footprints for MOSFETs. o More comments.
    [bitraf_hydroponics.sch]
2017-10-25 o Selecting the rest of the footprints. Using 0805 as default SMD size to make it makerspace friendly. o Some more nitpicking.
    [bitraf_hydroponics.kicad_pcb, bitraf_hydroponics.sch]
2017-10-25 rough sort of components
    [bitraf_hydroponics.kicad_pcb]
2017-10-26 schematic: o Changing 12V connector to the same as the rest. o Better label for Radio. o Changing R6 from SMD to THT so it is easier to customize with the LDR. pcb: o Adding copper zones connected to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
    [bitraf_hydroponics.kicad_pcb, bitraf_hydroponics.sch]
2017-10-26 switched position on SDA and SCL on the LCD header to match the rest of I2C bus
    [bitraf_hydroponics.sch]
2017-10-26 everything connected. Ugly and thin tracks where they should be wider, but passes test.
    [bitraf_hydroponics.kicad_pcb, bitraf_hydroponics.sch]
2017-10-26 Hmm. found a few unconnected Gnd's not picked up by test
    [bitraf_hydroponics.kicad_pcb]
2017-10-27 o Updating the symbol of P1 so it matches the other symbols.
    [bitraf_hydroponics.sch]
2017-10-27 o Switching from PhoenixContact_PTSM0,5_4-HV-2,5_SMD to PhoenixContact_PTSM0,5_2-2,5-H_SMD.
    [bitraf_hydroponics.sch]
2017-10-27 o Renaming BUZZ to BUZZER now that it is visible on the PCB.
    [bitraf_hydroponics.sch]
2017-10-27 o Switching to new footprints for connectors. Moves everything around a little bit. o Adding some silk screen text to better indicate what goes where.
    [bitraf_hydroponics.kicad_pcb, bitraf_hydroponics.sch]
2017-10-27 o Adding dimmensions on fab layer.
    [bitraf_hydroponics.kicad_pcb]
2017-10-28 o Adding datasheet for MOSFETs.
2017-10-29 o Adding IPython notebook for temperature calculations of the MOSFET.
2017-10-30 o My build tools.
    [digikey-footprints.csv, kicad-footprints.csv]
2017-11-08 o Adding mpn and other misc stuff. The forgotten commit.
    [bitraf_hydroponics.sch, digikey-footprints.csv, kicad-footprints.csv]
2017-11-08 adjusted pins to match new board design
2017-11-08 refactored loop over topic array to avoid using a variable to determine length of it. Topic array is now NULL termiated
    [Hydroponics.ino]
2017-11-08 removed definitions of pins and included them from board_config.h
2017-11-09 Added pullups and jumper header fro programming. Still need to tweak the mosfets, but need expert help
    [bitraf_hydroponics.sch]
2017-11-09 This should go in it's own branch/folder. Revert "Added pullups and jumper header fro programming. Still need to tweak the mosfets, but need expert help"
    This reverts commit b0ba335143d29f2dde67b78845eb19ede0b5a3d2.
    [bitraf_hydroponics.sch]
2017-11-09 o Initial work on a 1.1 revision.
    [bitraf_hydroponics.kicad_pcb, bitraf_hydroponics.sch, digikey-footprints.csv, kicad-footprints.csv]
2017-11-09 added pull-ups and jumper connector for programming
    [bitraf_hydroponics.sch]
2017-11-09 fixed faulty pull to GND in the jumper. Added a questions section in the README.md
    [bitraf_hydroponics.sch]
